lllx125/BabyYoda/(commit log)

2024-12-07 arduino code update to checkstop time
2025-04-12 added circuits doc
